evbuilder/BMSladderLeaf/GERBER/BMSladderLeaf-PTH-drl_map.dxf

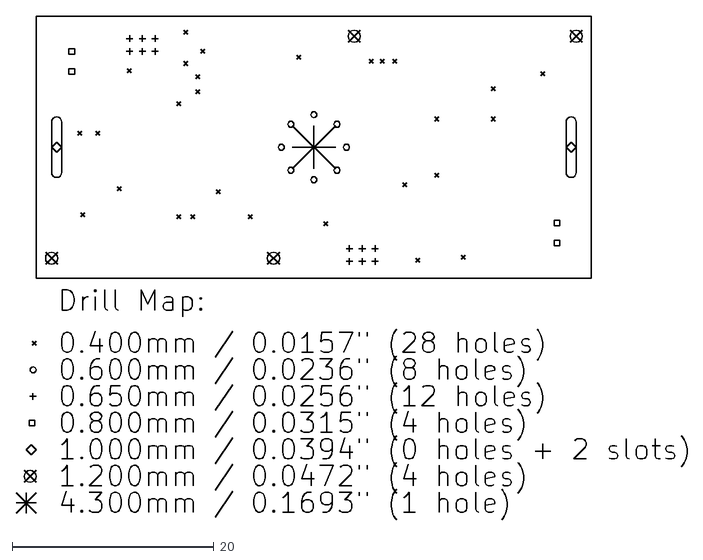
[picture p1: CAD file, 2024-05-28]
GERBER/BMSladderLeaf-PTH-drl_map.dxf
66.5 x 49.9
