evbuilder/BMSladderLeaf/GERBER/BMSladderLeaf-NPTH-drl_map.dxf

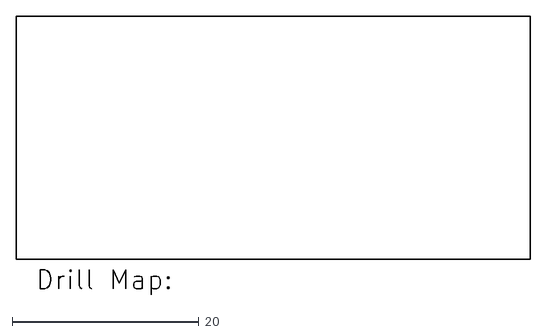
[picture p2: CAD file, 2024-05-28]
GERBER/BMSladderLeaf-NPTH-drl_map.dxf
55.0 x 29.8
