evbuilder/BMSladderLeaf/(list of files, cad)

Other CAD files:
BMSladderLeaf.skp
