evbuilder/BMSladderLeaf/BMSladderLeaf.kicad_pcb

## KiCad design BMSladderLeaf.kicad_pcb (2024-05-28)

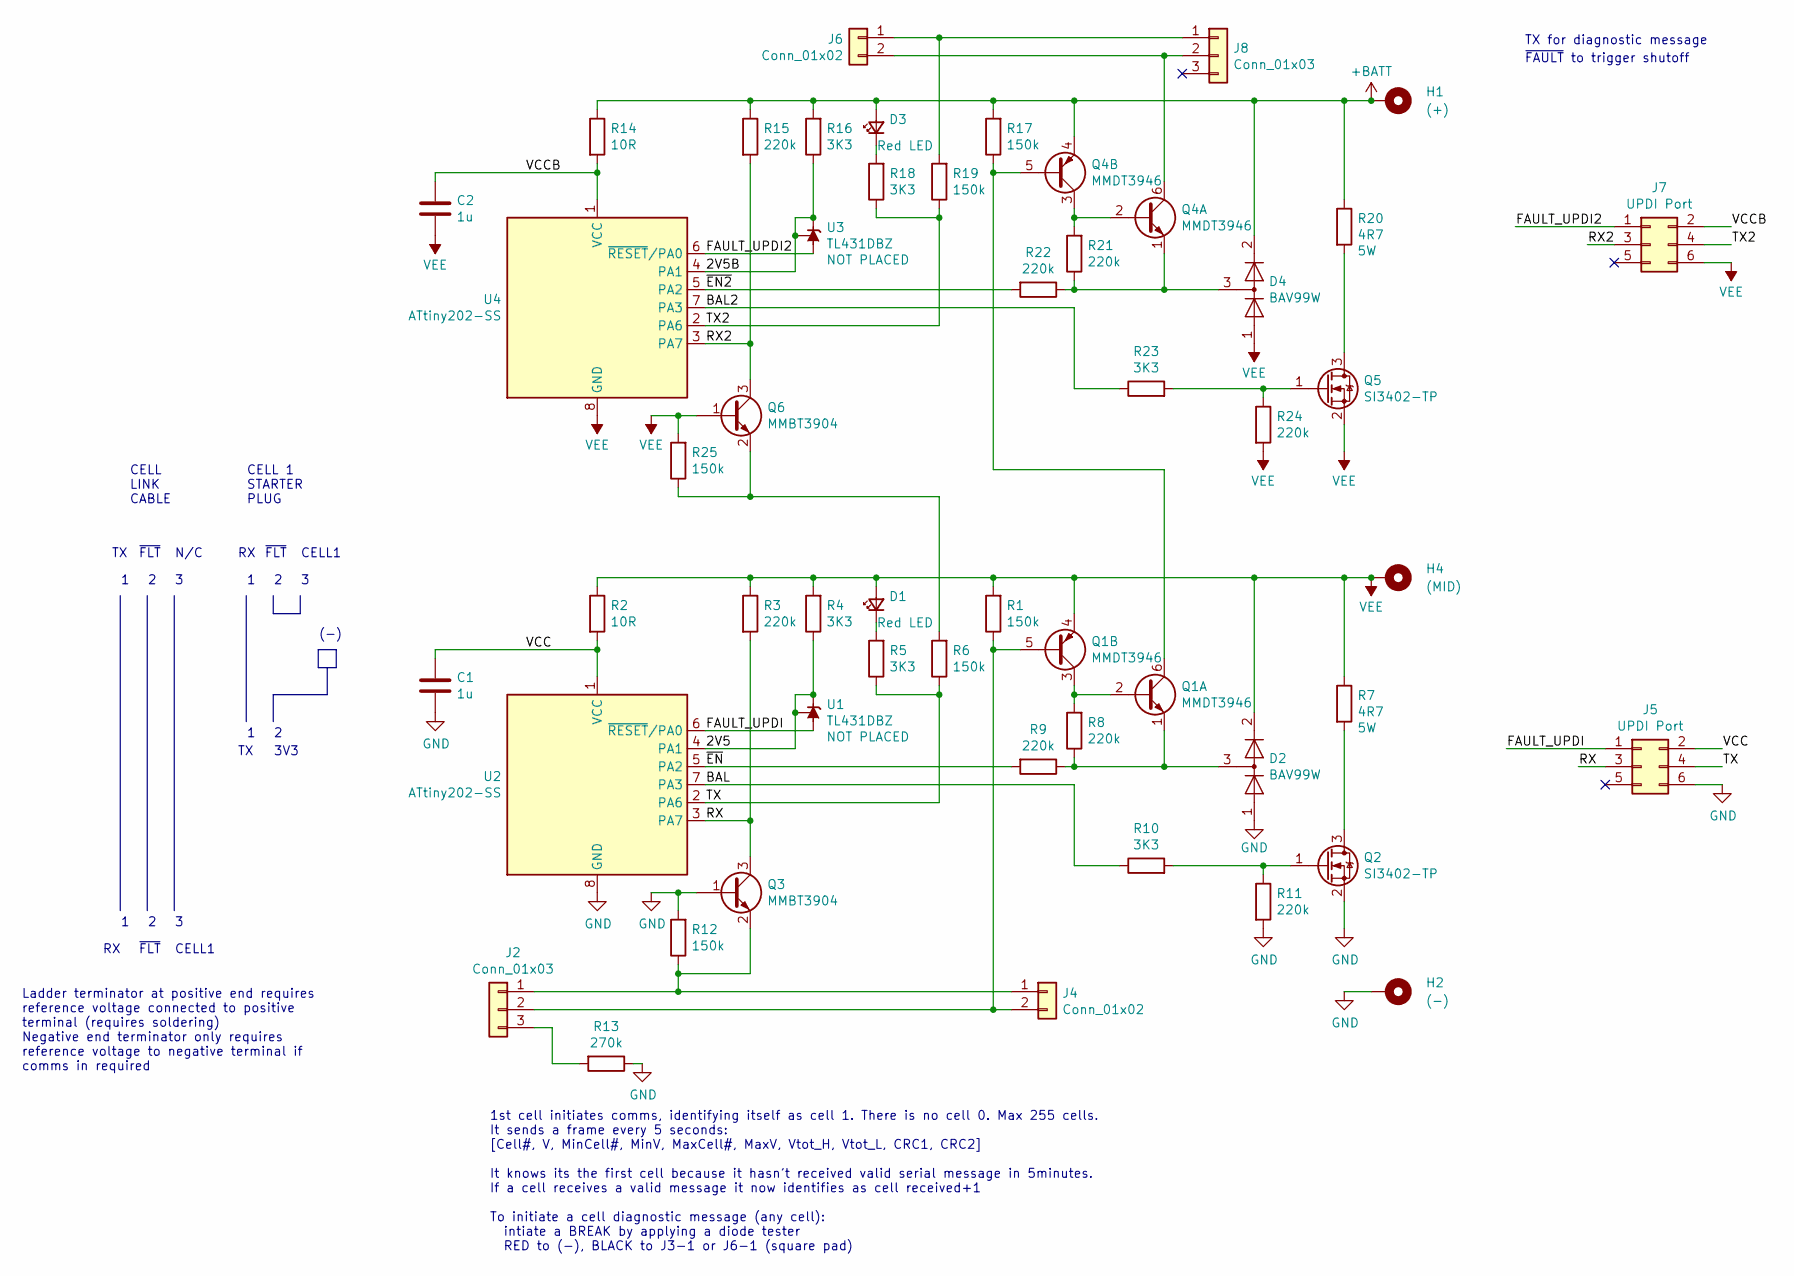
[picture p3: schematic BMSladderLeaf.kicad_sch, Link - for a Daisy Chain BMS]

Parts:
C1, C2: 1u; C_0603_1608Metric
D1, D3: Red LED; LED_0603_1608Metric
D2, D4: BAV99W; SOT-323_SC-70
H1: (+); Terminal tag 6.2mm slot
H2: (-); Terminal tag 6.2mm slot
H4: (MID); MountingHole_4.3mm_M4_Pad_Via
J2, J8: Conn_01x03; JST_SH_SM03B-SRSS-TB_1x03-1MP_P1.00mm_Horizontal
J4, J6: Conn_01x02; PinHeader_1x02_P2.00mm_Vertical
J5, J7: UPDI Port; PinHeader_2x03_P1.27mm_Vertical
Q1, Q4: MMDT3946; SOT-363_SC-70-6
Q2, Q5: SI3402-TP; SOT-23
Q3, Q6: MMBT3904; SOT-23
R1, R6, R12, R17, R19, R25: 150k; R_0603_1608Metric
R2, R14: 10R; R_0603_1608Metric
R3, R8, R9, R11, R15, R21, R22, R24: 220k; R_0603_1608Metric
R4, R5, R10, R16, R18, R23: 3K3; R_0603_1608Metric
R7, R20: 4R7; R_Axial_L17.0mm_D6.0mm_P22mm_Horizontal
R13: 270k; R_0603_1608Metric
U1, U3: TL431DBZ; SOT-23
U2, U4: ATtiny202-SS; SOIC-8_3.9x4.9mm_P1.27mm

Connections:
+BATT: D3.2 (A), D4.2 (A), H1.1, Q4.4 (E2), R14.1, R15.1, R16.2, R17.2, R20.1
/2V5: R4.1, U1.1 (K), U1.2 (REF), U2.4 (PA1)
/2V5B: R16.1, U3.1 (K), U3.2 (REF), U4.4 (PA1)
/BAL: R10.1, U2.7 (PA3)
/BAL2: R23.1, U4.7 (PA3)
/FAULT_UPDI: J5.1, U1.3 (A), U2.6 (~RESET/PA0)
/FAULT_UPDI2: J7.1, U3.3 (A), U4.6 (~RESET/PA0)
/RX: J5.3, Q3.3 (C), R3.2, U2.3 (PA7)
/RX2: J7.3, Q6.3 (C), R15.2, U4.3 (PA7)
/TX: J5.4, R5.1, R6.1, U2.2 (PA6)
/TX2: J7.4, R18.1, R19.1, U4.2 (PA6)
/VCC: C1.1, J5.2, R2.2, U2.1 (VCC)
/VCCB: C2.1, J7.2, R14.2, U4.1 (VCC)
/~EN2: R22.2, U4.5 (PA2)
/~EN: R9.2, U2.5 (PA2)
GND: C1.2, D2.1 (K), H2.1, J5.6, Q2.2 (S), Q3.1 (B), R11.2, R12.2, R13.1, U2.8 (GND)
unnamed: D1.1 (K), R5.2
unnamed: D3.1 (K), R18.2
unnamed: J2.1, J4.1, Q3.2 (E), R12.1
unnamed: J2.2, J4.2, Q1.5 (B2), R1.1
unnamed: J2.3, R13.2
unnamed: J6.1, J8.1, R19.2
unnamed: J6.2, J8.2, Q4.6 (C1)
unnamed: Q1.2 (B1), Q1.3 (C2), R8.2
unnamed: Q1.6 (C1), Q4.5 (B2), R17.1
unnamed: D2.3 (K), Q1.1 (E1), R8.1, R9.1
unnamed: Q2.3 (D), R7.2
unnamed: Q2.1 (G), R10.2, R11.1
unnamed: Q4.2 (B1), Q4.3 (C2), R21.2
unnamed: D4.3 (K), Q4.1 (E1), R21.1, R22.1
unnamed: Q5.3 (D), R20.2
unnamed 31: Q5.1 (G), R23.2, R24.1; also elsewhere on the board
unnamed: Q6.2 (E), R6.2, R25.1
VEE: C2.2, D1.2 (A), D2.2 (A), D4.1 (K), H4.1, J7.6, Q1.4 (E2), Q5.2 (S), Q6.1 (B), R1.2, R2.1, R3.1, R4.2, R7.1, R24.2, R25.2, U4.8 (GND); also elsewhere on the board

Notes on the sheet:
CELL1
~{FAULT} to trigger shutoff
CELL 1 STARTER PLUG
Ladder terminator at positive end requires reference voltage connected to positive terminal (requires soldering) Negative end terminator only requires reference voltage to negative terminal if comms in required
1st cell initiates comms, identifying itself as cell 1. There is no cell 0. Max 255 cells. It sends a frame every 5 seconds: [Cell#, V, MinCell#, MinV, MaxCell#, MaxV, Vtot_H, Vtot_L, CRC1, CRC2] It knows its the first cell because it hasn’t received valid serial message in 5minutes. If a cell rece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
~{FLT}
N/C
3V3
TX for diagnostic message
CELL LINK CABLE
(-)

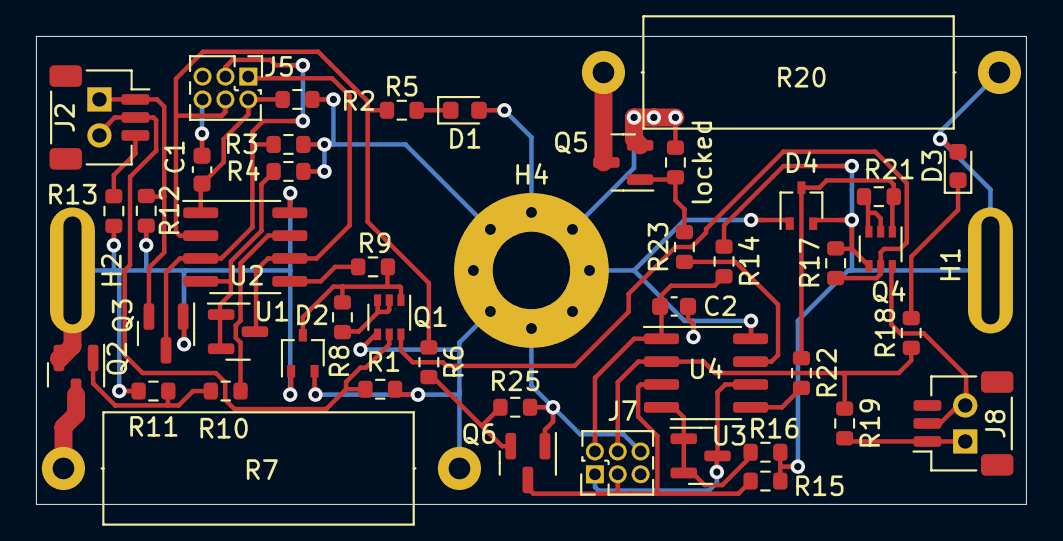
[picture p4: board BMSladderLeaf.kicad_pcb from above]

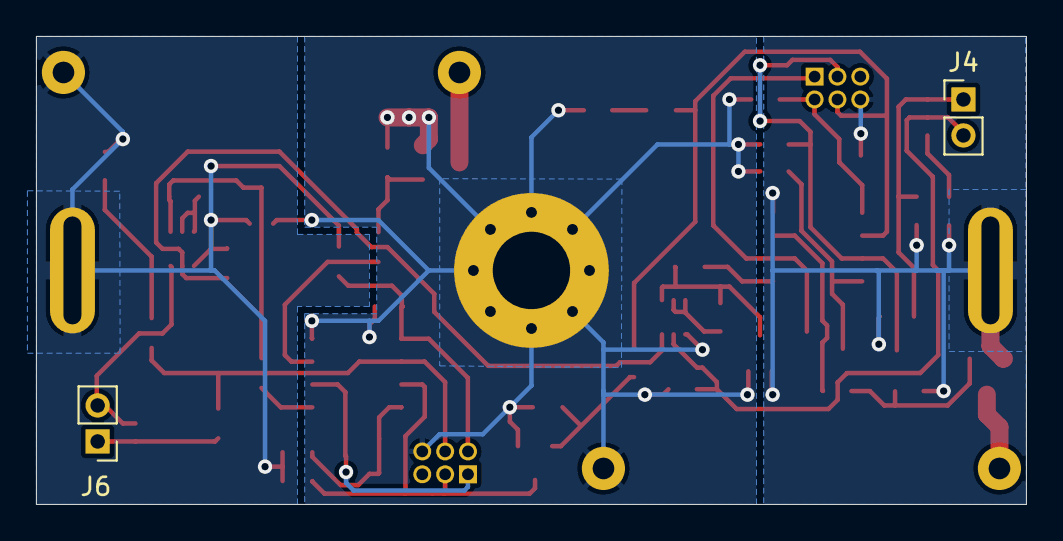
[picture p5: board BMSladderLeaf.kicad_pcb from below]

Board: 2 copper layers, 55.0 x 26.0 mm, 50 parts (2 on the bottom side), 34 nets.

Other parts of the board:
locked: 220k; R_0603_1608Metric

Their connections:
unnamed 31: locked.1; also elsewhere on the board
VEE: locked.2; also elsewhere on the board
