evbuilder/BMSladderLeaf/(notices)

Notices in the files:
BMSladderLeaf.kicad_pcb:
REV 1.1 (c) 2024 EHC
